RoMedias/sensor_motor_lab/pot_tf.png

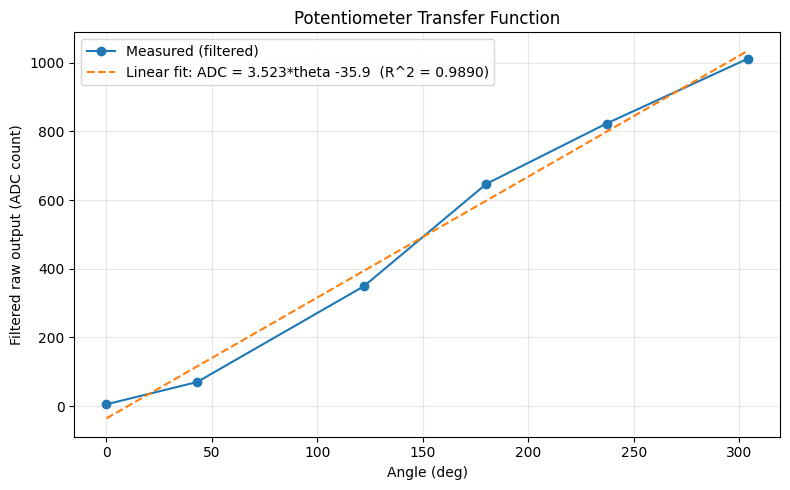
pot_tf.png
