RoMedias/sensor_motor_lab/(commit log)

2026-11-09 Add ROS 2 serial bridge, fake Arduino, protocol spec and pinout
2026-11-10 arduino placeholder
2026-11-10 create arduino function signatures and provide overall structure
2026-11-10 create fake_arduino.py to mock hardware sensors and reply with recieved message
2026-11-10 Added the interfacing commands for flex and stepper.cpp NOT TESTED OR CALIBRATED FOR FLEX - Bill
    [flex.cpp, function_sigs.h, stepper.cpp]
2026-11-10 Added potentiometer library
    Averages 4 reads per call to denoise. Needs angle calibration - same data for transfer function plot
2026-11-10 Added dc motor+encoder library
2026-11-10 TOF and button initialisation and updating
2026-11-10 Added servo and slot sensor
2026-11-10 updated min max for flex and stepper
    [main.ino]
2026-11-12 calibrated dc motor and flex sensor for angles
    [dc.cpp, flex.cpp, function_sigs.h, lab_modules.h, main.ino]
